Pranavkrishna481/6dof-robotic-arm-gesture-control/(commit log)

2026-08-08 Initial commit : gesture controlled 6DoF arm
2026-09-21 add demo videos of arm in action
